smonrou/microprocesador-8bit-ttl/imagenes/cableado_pruebas.jpeg

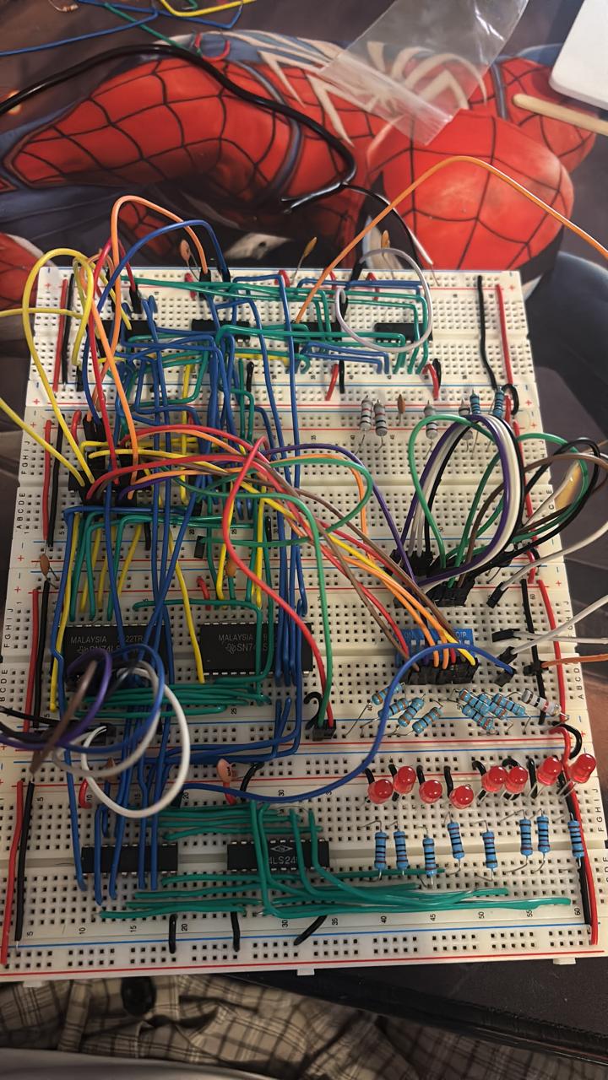
imagenes/cableado_pruebas.jpeg
