smonrou/microprocesador-8bit-ttl/imagenes/pruebas3.jpeg

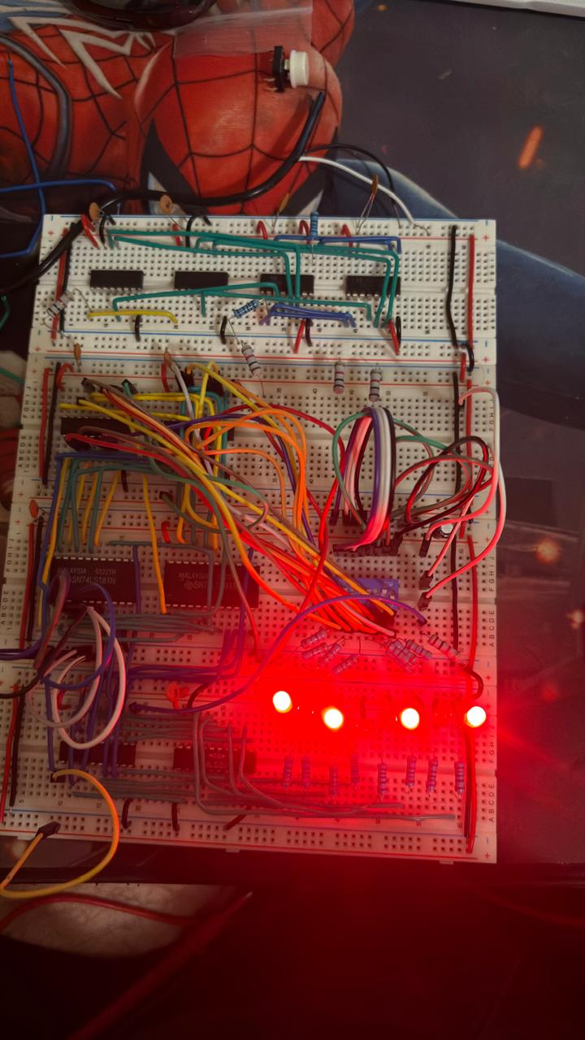
imagenes/pruebas3.jpeg
