smonrou/microprocesador-8bit-ttl/README.md

# Microprocesador 8-bit TTL

Microprocesador de 8 bits construido con lógica TTL discreta (ALU SN74LS181, registros 74LS273, multiplexores 74LS157), controlado por un Arduino Mega que actúa **únicamente** como unidad de control, RAM y reloj. El contador de programa (PC) también es hardware (2× 74LS161) y la salida son 8 LEDs a través de un 74LS240. Toda operación aritmética y lógica ocurre en el hardware TTL, nunca en el microcontrolador.

Este repositorio contiene las implementaciones del mismo ISA (juego de instrucciones), mantenidas sincronizadas por una suite de pruebas compartida:

- **`asm/`**: ensamblador de dos pasadas que traduce programas fuente `.asm` al binario de 256 bytes que carga la máquina.
- **`firmware/`**: firmware en C++ para el Arduino Mega, con una capa HAL que separa el núcleo de control (probado en PC) de las implementaciones reales/simuladas de hardware.
- **`depurador/`**: depurador gráfico (Tkinter) para inspeccionar y depurar la ejecución en el hardware real por puerto serie. No depende de `asm/`.
- **`montaje/`**: fuente de verdad del montaje físico en 4 protoboards (`netlist.py`), generador de planos SVG y guías por fase, y la bitácora de lo que realmente pasó (`bitacora_montaje.md`).
- **`compañero/`**: sketch de un compañero, **externo** al diseño de este repositorio y no cubierto por las pruebas.
- **`programas/`**: programas de ejemplo en ensamblador, incluido el programa de referencia (multiplicación por sumas repetidas) y `diagnostico/` (programas para diagnosticar el cableado).
- **`tests/`**: suite de pruebas que valida que las implementaciones (ensamblador, firmware compilado en PC) produzcan resultados idénticos. No ejercen el hardware físico: eso se prueba en la protoboard (ver `montaje/bitacora_montaje.md`).

## Arquitectura

- **ISA fijo de 16 instrucciones**, opcode de 4 bits en el nibble alto del primer byte, instrucciones de 1 o 2 bytes.
- **Memoria von Neumann de 256 bytes**: `0x00`–`0xBF` programa, `0xC0`–`0xFF` datos (convención respetada por el ensamblador, no impuesta por el hardware).
- **ALU SN74LS181**: suma, resta, AND, OR, XOR; solo estas cinco operaciones actualizan las banderas Z (cero) y C (acarreo).
- **Sintaxis de mnemónicos estilo x86** (desde 2026-09-28): `MOV A,[200]` (directo), `MOV A,5` (inmediato), `MOV [200],A` (guardar); sin `#`.
- **Frontera HAL en el firmware**: el núcleo de control (`nucleo.cpp`) no toca pines ni hace I/O directamente. Corre igual sobre hardware real (`hal_arduino.cpp`) o sobre un emulador de los chips TTL (`hal_falso.cpp`) usado en las pruebas de PC.

## Requisitos

| Requisito | Comprobación |
|---|---|
| Python 3.8 o superior | `python --version` |
| pytest | `python -m pip install pytest` |
| g++ (opcional, para pruebas de firmware) | `g++ --version` |

## Instalación

```bash
git clone https://github.com/smonrou/microprocesador-8bit-ttl.git
cd microprocesador-8bit-ttl
python -m pip install -r requirements.txt   # opcional: solo necesario para conectar por serie a un Arduino real
```

## Uso rápido

```bash
# Ejecutar toda la suite de pruebas
python -m pytest -q

# Ensamblar un programa
python -m asm programas/referencia.asm

# Ver el listado sin escribir archivos
python -m asm programas/referencia.asm --listing-only

# Recorrido de demostración de todo el sistema (8 pasos)
python demo.py
python demo.py 4          # solo el paso 4
python demo.py --lista    # listar pasos disponibles
```

## Ejecutar pruebas específicas

```bash
python -m pytest tests/test_asm_errors.py -v   # un archivo
python -m pytest -k "reference" -v              # por nombre
python -m pytest -k firmware -v                 # solo pruebas de firmware (compilan C++ con g++)
```

## Estructura del repositorio

```
.
├── asm/          # ensamblador de dos pasadas (Python)
├── firmware/     # firmware del Arduino Mega (C++), su capa HAL y los sketches de prueba (prueba_fase4/5)
├── depurador/    # depurador gráfico Tkinter
├── programas/    # programas de ejemplo en ensamblador (+ diagnostico/)
├── montaje/      # netlist, planos, guías por fase y bitácora del montaje físico
├── compañero/    # sketch externo de un compañero (no es parte del diseño)
├── tests/        # suite de pruebas compartida
├── demo.py       # recorrido de demostración end-to-end
├── pytest.ini
├── requirements.txt
└── LICENSE
```

## Estado del proyecto

El diseño lógico, el ensamblador y el firmware están completos y validados por pruebas automatizadas. El circuito físico está terminado en 4 protoboards con el Arduino Mega y **funciona completo** (2026-10-02): las 6 fases del montaje pasaron sus pruebas,.

## Licencia

MIT, ver [LICENSE](LICENSE).
