smonrou/microprocesador-8bit-ttl/imagenes/fase2.jpeg

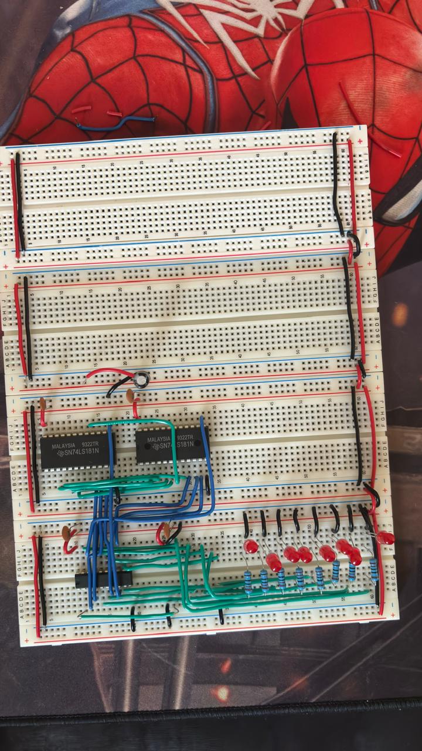
imagenes/fase2.jpeg
