smonrou/microprocesador-8bit-ttl/imagenes/fase4.jpeg

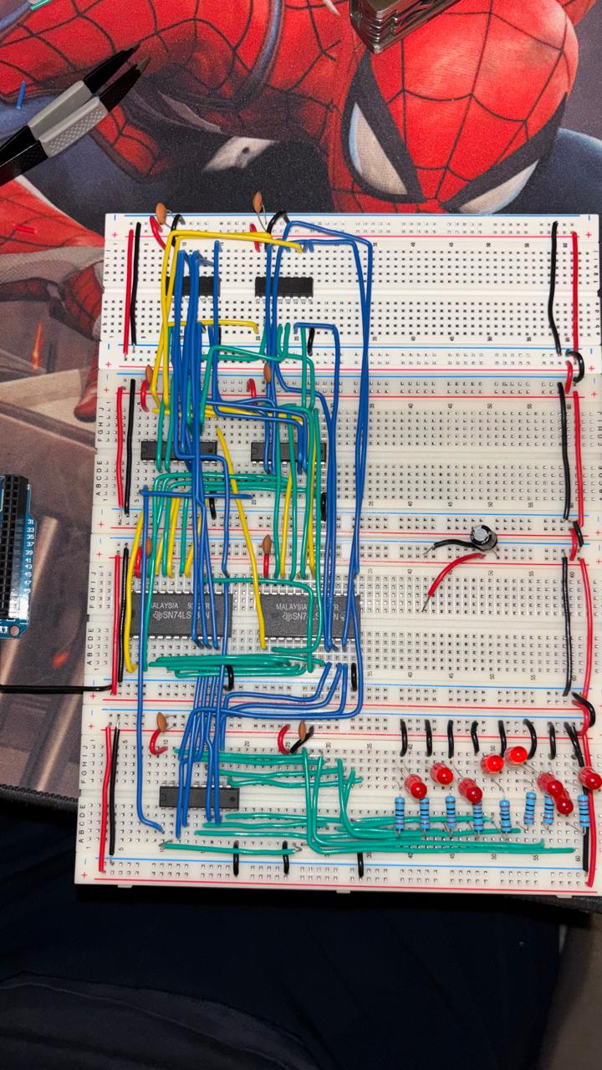
imagenes/fase4.jpeg
