smonrou/microprocesador-8bit-ttl/imagenes/faseFinal.jpeg

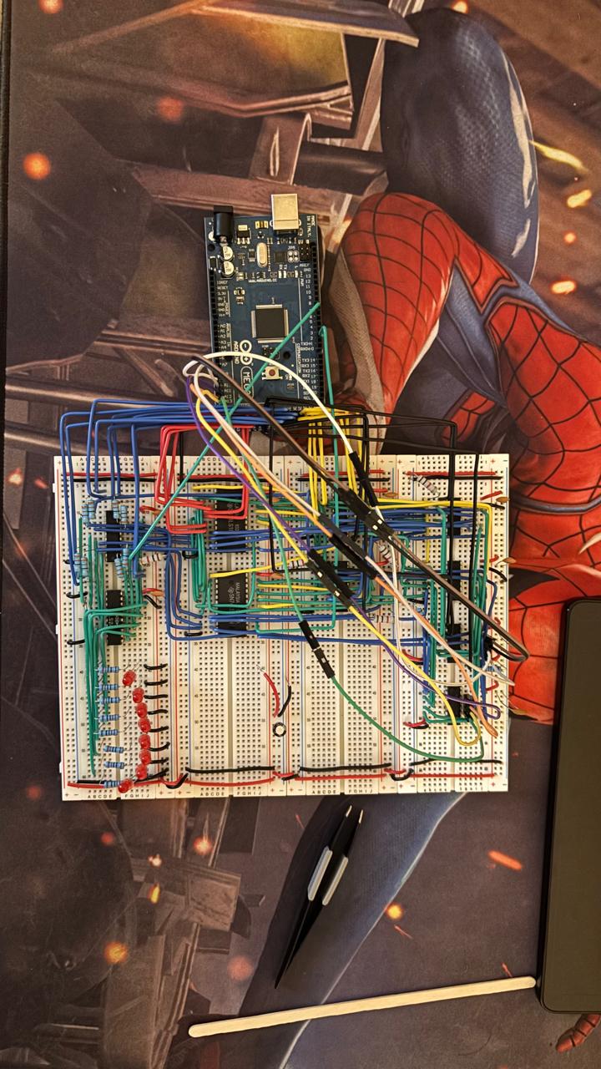
imagenes/faseFinal.jpeg
