smonrou/microprocesador-8bit-ttl/imagenes/WhatsApp Image 2026-10-04 at 1.18.01 PM (1).jpeg

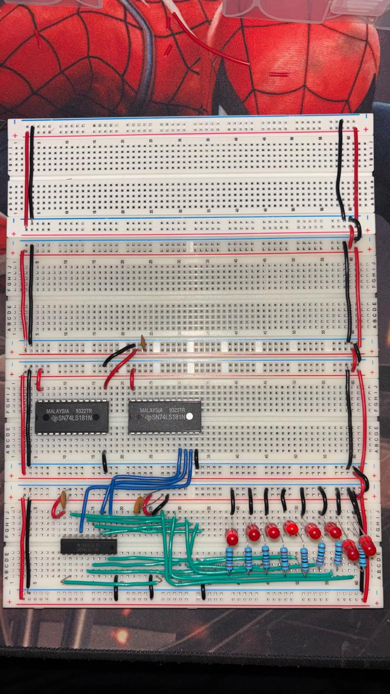
imagenes/WhatsApp Image 2026-10-04 at 1.18.01 PM (1).jpeg
