smonrou/microprocesador-8bit-ttl/depurador/desensamblador.py

"""Desensamblador: bytes de memoria -> mnemónico + operando.

Lee la tabla de opcodes de ``depurador.isa``; este módulo no contiene ni un
solo literal de opcode.

La sintaxis emitida es la misma que acepta el ensamblador (``MOV A,0x04``,
``MOV A,[0xC8]``, ``JNZ 0x0A``), así que lo desensamblado se puede volver a
ensamblar.

Módulo puro: no toca sockets, hilos ni Tkinter.
"""

from dataclasses import dataclass
from typing import List, Optional, Sequence

from .isa import TABLA_DE_OPCODES

TAMANO_MEMORIA = 256


@dataclass(frozen=True)
class LineaDesensamblada:
    direccion: int
    bytes_crudos: List[int]
    mnemonico: str
    operando: Optional[int]
    texto: str          # "MOV A,[0xC8]" — listo para pintar

    @property
    def longitud(self) -> int:
        return len(self.bytes_crudos)


def _leer(memoria: Sequence[int], direccion: int) -> int:
    return memoria[direccion & 0xFF] & 0xFF


def desensamblar_en(memoria: Sequence[int], direccion: int) -> LineaDesensamblada:
    """Desensambla la instrucción que empieza en ``direccion``.

    El opcode son SIEMPRE los 4 bits altos del primer byte (A.4), así que
    cualquier byte decodifica: no existe el "opcode inválido". Los 4 bits bajos
    del primer byte no se usan y se ignoran, igual que en el hardware.
    """
    direccion &= 0xFF
    primero = _leer(memoria, direccion)
    spec = TABLA_DE_OPCODES[primero >> 4]

    if spec.longitud == 1:
        return LineaDesensamblada(
            direccion=direccion,
            bytes_crudos=[primero],
            mnemonico=spec.mnemonico,
            operando=None,
            texto=spec.mnemonico,
        )

    operando = _leer(memoria, direccion + 1)
    valor = f"0x{operando:02X}"
    if "[dir]" in spec.mnemonico:          # MOV A,[dir] / MOV [dir],A
        texto = spec.mnemonico.replace("[dir]", f"[{valor}]")
    elif spec.mnemonico.endswith(",inm"):  # MOV A,inm
        texto = spec.mnemonico[: -len("inm")] + valor
    else:                                 # JMP/JZ/JNZ: dirección pelada
        texto = f"{spec.mnemonico} {valor}"

    return LineaDesensamblada(
        direccion=direccion,
        bytes_crudos=[primero, operando],
        mnemonico=spec.mnemonico,
        operando=operando,
        texto=texto,
    )


def mnemonico_de(ir: int) -> str:
    """El nemónico de un IR suelto, sin necesidad de la memoria.

    Sirve para la línea ``#pc=...`` de STATE, que trae el IR pero no el
    operando. El opcode son los 4 bits altos (A.4), así que los 16 valores
    existen y esto nunca falla.
    """
    return TABLA_DE_OPCODES[(ir >> 4) & 0xF].mnemonico


def desensamblar(memoria: Sequence[int], inicio: int = 0,
                 fin: int = TAMANO_MEMORIA - 1) -> List[LineaDesensamblada]:
    """Desensambla linealmente desde ``inicio`` hasta ``fin`` (ambos incluidos).

    Lineal a propósito: no sigue saltos ni intenta adivinar dónde acaba el
    código y empieza la zona de datos. El mapa 0x00-0xBF / 0xC0-0xFF es una
    CONVENCIÓN (A.6), no algo que el hardware imponga, así que un desensamblador
    que decidiera solo dónde cortar estaría inventando.

    Una instrucción de 2 bytes que empieza justo en ``fin`` se emite completa.
    """
    lineas: List[LineaDesensamblada] = []
    direccion = inicio
    while direccion <= fin:
        linea = desensamblar_en(memoria, direccion)
        lineas.append(linea)
        direccion += linea.longitud
    return lineas


def indice_por_direccion(lineas: Sequence[LineaDesensamblada]) -> dict:
    """Mapa dirección -> posición en la lista, para resaltar la línea del PC.

    Solo se indexa el PRIMER byte de cada instrucción: si el PC cayera en el
    operando de una instrucción de 2 bytes (posible con un salto a media
    instrucción), no hay línea que resaltar y es correcto no resaltar ninguna.
    """
    return {linea.direccion: posicion for posicion, linea in enumerate(lineas)}
