smonrou/microprocesador-8bit-ttl/depurador/gui.py

"""Panel frontal en Tkinter del depurador.

Aquí solo se arman widgets y se cablean botones; la lógica que se puede
probar sin pantalla está en los otros módulos del paquete.
"""

import os
import tkinter as tk
from tkinter import filedialog, messagebox, ttk
from typing import List, Optional

from . import (cargador, desensamblador, formato_numerico, protocolo,
               pruebas_rapidas, transporte)

MONOESPACIADA = ("Consolas", 9)
MONOESPACIADA_GRANDE = ("Consolas", 11, "bold")
MONOESPACIADA_COMPACTA = ("Consolas", 7)
TITULO_MEMORIA = "Memoria 256 B"
ANCHO_DESENSAMBLADO = 28
ANCHO_DESENSAMBLADO_COMPACTO = 24

COLOR_FONDO = "#1e1e1e"
COLOR_PANEL = "#252526"
COLOR_TEXTO = "#d4d4d4"
COLOR_APAGADO = "#6a6a6a"
COLOR_RESALTE = "#264f78"
COLOR_ACTIVO = "#4ec9b0"
COLOR_BANDERA = "#f0c674"
COLOR_ENVIADO = "#569cd6"

MILISEGUNDOS_ENTRE_DRENAJES = 50
RETARDO_POR_DEFECTO = 200
FILAS_MEMORIA = 16
COLUMNAS_MEMORIA = 16


class Depurador:
    def __init__(self, raiz: tk.Tk) -> None:
        self.raiz = raiz
        self.raiz.title("Depurador: microprocesador de 8 bits")
        self.raiz.configure(bg=COLOR_FONDO)

        self.canal: Optional[transporte.Transporte] = None
        self.ensamblador = protocolo.EnsambladorDeBloques()
        self.memoria: List[int] = [0] * 256
        self.pendientes_de_carga: List[str] = []
        self.corriendo = False
        self.registro_a = 0
        self.registro_b = 0
        self.pc = 0
        self.ir = 0
        self.lineas_desensambladas: List[desensamblador.LineaDesensamblada] = []
        self.pasos_prueba: List[pruebas_rapidas.Paso] = []

        self._construir()
        self._pintar_memoria()
        self._pintar_desensamblado()
        self._refrescar_puertos()
        self.raiz.after(MILISEGUNDOS_ENTRE_DRENAJES, self._drenar)
        self.raiz.protocol("WM_DELETE_WINDOW", self._al_cerrar)

    def _construir(self) -> None:
        self._construir_barra_conexion()

        cuerpo = tk.Frame(self.raiz, bg=COLOR_FONDO)
        cuerpo.pack(fill="both", expand=True, padx=6, pady=4)

        izquierda = tk.Frame(cuerpo, bg=COLOR_FONDO)
        izquierda.pack(side="left", fill="y")
        self._construir_registros(izquierda)
        self._construir_banderas(izquierda)
        self._construir_alu(izquierda)
        self._construir_controles(izquierda)

        centro = tk.Frame(cuerpo, bg=COLOR_FONDO)
        centro.pack(side="left", fill="both", expand=True, padx=6)
        self._construir_memoria(centro)

        derecha = tk.Frame(cuerpo, bg=COLOR_FONDO)
        derecha.pack(side="left", fill="both")
        self._construir_desensamblado(derecha)

        # oculto hasta pulsar Pruebas rápidas
        self.marco_pruebas = tk.Frame(cuerpo, bg=COLOR_FONDO)
        self._construir_pruebas_rapidas(self.marco_pruebas)

        self._construir_registros_de_texto()

    def _marco(self, padre, titulo) -> tk.LabelFrame:
        return tk.LabelFrame(padre, text=titulo, bg=COLOR_PANEL, fg=COLOR_ACTIVO,
                             font=MONOESPACIADA, bd=1, relief="solid",
                             labelanchor="nw", padx=6, pady=4)

    def _etiqueta(self, padre, texto="", color=COLOR_TEXTO,
                  fuente=MONOESPACIADA, **opciones) -> tk.Label:
        return tk.Label(padre, text=texto, bg=COLOR_PANEL, fg=color,
                        font=fuente, anchor="w", **opciones)

    def _construir_barra_conexion(self) -> None:
        barra = tk.Frame(self.raiz, bg=COLOR_PANEL, pady=4, padx=6)
        barra.pack(fill="x")

        tk.Label(barra, text="puerto serie:", bg=COLOR_PANEL, fg=COLOR_TEXTO,
                 font=MONOESPACIADA).pack(side="left")
        self.puerto_elegido = tk.StringVar()
        self.combo_puertos = ttk.Combobox(barra, textvariable=self.puerto_elegido,
                                          width=14, state="readonly",
                                          font=MONOESPACIADA)
        self.combo_puertos.pack(side="left", padx=4)

        self.boton_refrescar = tk.Button(barra, text="↻", font=MONOESPACIADA,
                                         command=self._refrescar_puertos)
        self.boton_refrescar.pack(side="left")

        self.boton_conectar = tk.Button(barra, text="Conectar", font=MONOESPACIADA,
                                        width=12, command=self._alternar_conexion)
        self.boton_conectar.pack(side="left", padx=8)

        self.estado_conexion = tk.Label(barra, text="desconectado", bg=COLOR_PANEL,
                                        fg=COLOR_APAGADO, font=MONOESPACIADA)
        self.estado_conexion.pack(side="left")

        self.boton_pruebas = tk.Button(barra, text="Pruebas rápidas ▸",
                                       font=MONOESPACIADA,
                                       command=self._alternar_pruebas)
        self.boton_pruebas.pack(side="right")

    def _construir_registros(self, padre) -> None:
        marco = self._marco(padre, "Registros (74LS273)")
        marco.pack(fill="x", pady=2)

        encabezados = ("", "hex", "binario", "sin signo", "con signo")
        for columna, texto in enumerate(encabezados):
            self._etiqueta(marco, texto, COLOR_APAGADO).grid(
                row=0, column=columna, sticky="w", padx=4)

        self.celdas_registro = {}
        for fila, nombre in enumerate(("A", "B"), start=1):
            self._etiqueta(marco, nombre, COLOR_ACTIVO,
                           MONOESPACIADA_GRANDE).grid(row=fila, column=0, padx=4)
            self.celdas_registro[nombre] = []
            for columna in range(1, 5):
                celda = self._etiqueta(marco, "-", width=11)
                celda.grid(row=fila, column=columna, sticky="w", padx=4)
                self.celdas_registro[nombre].append(celda)

        marco_control = self._marco(padre, "Unidad de control")
        marco_control.pack(fill="x", pady=2)
        self.etiqueta_pc = self._etiqueta(marco_control, "PC  = 0x00  (0)")
        self.etiqueta_pc.pack(fill="x")
        self.etiqueta_ir = self._etiqueta(marco_control, "IR  = 0x00  NOP")
        self.etiqueta_ir.pack(fill="x")
        self.etiqueta_ciclo = self._etiqueta(marco_control, "ciclo -   paso -",
                                             COLOR_APAGADO)
        self.etiqueta_ciclo.pack(fill="x")

    def _construir_banderas(self, padre) -> None:
        marco = self._marco(padre, "Banderas")
        marco.pack(fill="x", pady=2)

        self.etiquetas_bandera = {}
        for columna, (nombre, ayuda) in enumerate(
                (("Z", "resultado cero"), ("C", "acarreo"))):
            caja = tk.Frame(marco, bg=COLOR_PANEL)
            caja.grid(row=0, column=columna, padx=10, pady=2)
            etiqueta = tk.Label(caja, text=f"{nombre}=0", bg=COLOR_FONDO,
                                fg=COLOR_APAGADO, font=MONOESPACIADA_GRANDE,
                                width=5, relief="solid", bd=1)
            etiqueta.pack()
            tk.Label(caja, text=ayuda, bg=COLOR_PANEL, fg=COLOR_APAGADO,
                     font=("Consolas", 7)).pack()
            self.etiquetas_bandera[nombre] = etiqueta

        self.etiqueta_detenido = self._etiqueta(marco, "CPU lista", COLOR_ACTIVO)
        self.etiqueta_detenido.grid(row=1, column=0, columnspan=2, sticky="w")

    def _construir_alu(self, padre) -> None:
        marco = self._marco(padre, "ALU 2x SN74LS181")
        marco.pack(fill="x", pady=2)
        self.etiqueta_alu = self._etiqueta(marco, "M=-  S=----  Cn=-")
        self.etiqueta_alu.pack(fill="x")
        self.etiqueta_alu_nota = self._etiqueta(
            marco, "(sin operación de ALU todavía)", COLOR_APAGADO)
        self.etiqueta_alu_nota.pack(fill="x")

    def _construir_controles(self, padre) -> None:
        marco = self._marco(padre, "Ejecución")
        marco.pack(fill="x", pady=2)

        botones = tk.Frame(marco, bg=COLOR_PANEL)
        botones.pack(fill="x")
        self.botones_comando = {}
        for columna, orden in enumerate(("RUN", "STEP", "RESET", "BORRAR")):
            boton = tk.Button(botones, text=orden, font=MONOESPACIADA, width=7,
                              state="disabled",
                              command=lambda o=orden: self._enviar_comando(o))
            boton.grid(row=0, column=columna, padx=2, pady=2)
            self.botones_comando[orden] = boton

        self.boton_estado = tk.Button(botones, text="STATE", font=MONOESPACIADA,
                                      width=7, state="disabled",
                                      command=lambda: self._enviar_comando("STATE"))
        self.boton_estado.grid(row=1, column=0, padx=2, pady=2)
        self.botones_comando["STATE"] = self.boton_estado

        self.boton_dump = tk.Button(botones, text="DUMP", font=MONOESPACIADA,
                                    width=7, state="disabled",
                                    command=self._pedir_memoria)
        self.boton_dump.grid(row=1, column=1, padx=2, pady=2)
        self.botones_comando["DUMP"] = self.boton_dump

        self.boton_cargar = tk.Button(botones, text="Cargar .load",
                                      font=MONOESPACIADA, width=16,
                                      state="disabled", command=self._cargar_archivo)
        self.boton_cargar.grid(row=1, column=2, columnspan=2, padx=2, pady=2)
        self.botones_comando["CARGAR"] = self.boton_cargar

        # VEL: retardo entre instrucciones en RUN, 0-5000 ms
        velocidad = tk.Frame(marco, bg=COLOR_PANEL)
        velocidad.pack(fill="x", pady=(6, 0))
        tk.Label(velocidad, text="VEL", bg=COLOR_PANEL, fg=COLOR_TEXTO,
                 font=MONOESPACIADA).pack(side="left")
        self.velocidad = tk.IntVar(value=RETARDO_POR_DEFECTO)
        tk.Scale(velocidad, from_=0, to=5000, resolution=50, orient="horizontal",
                 variable=self.velocidad, bg=COLOR_PANEL, fg=COLOR_TEXTO,
                 troughcolor=COLOR_FONDO, highlightthickness=0, length=170,
                 font=("Consolas", 7)).pack(side="left", fill="x", expand=True)
        self.boton_velocidad = tk.Button(velocidad, text="ms", font=MONOESPACIADA,
                                         state="disabled",
                                         command=self._aplicar_velocidad)
        self.boton_velocidad.pack(side="left")
        self.botones_comando["VEL"] = self.boton_velocidad

    def _construir_memoria(self, padre) -> None:
        marco = self._marco(padre, TITULO_MEMORIA)
        marco.pack(fill="both", expand=True)
        self.marco_memoria = marco

        rejilla = tk.Frame(marco, bg=COLOR_PANEL)
        rejilla.pack()

        self.ejes_memoria = []
        for columna in range(COLUMNAS_MEMORIA):
            eje = self._etiqueta(rejilla, f"{columna:X}", COLOR_APAGADO)
            eje.grid(row=0, column=columna + 1, padx=1)
            self.ejes_memoria.append(eje)

        self.celdas_memoria = []
        for fila in range(FILAS_MEMORIA):
            eje = self._etiqueta(rejilla, f"{fila * 16:02X}", COLOR_APAGADO)
            eje.grid(row=fila + 1, column=0, padx=(0, 4))
            self.ejes_memoria.append(eje)
            for columna in range(COLUMNAS_MEMORIA):
                celda = tk.Label(rejilla, text="00", bg=COLOR_FONDO, fg=COLOR_TEXTO,
                                 font=MONOESPACIADA, width=2, padx=2)
                celda.grid(row=fila + 1, column=columna + 1, padx=1, pady=1)
                self.celdas_memoria.append(celda)

    def _construir_desensamblado(self, padre) -> None:
        marco = self._marco(padre, "Desensamblado")
        marco.pack(fill="both", expand=True)

        self.lista_desensamblado = tk.Listbox(
            marco, font=MONOESPACIADA, bg=COLOR_FONDO, fg=COLOR_TEXTO,
            width=ANCHO_DESENSAMBLADO, height=24, selectbackground=COLOR_RESALTE, selectforeground="white",
            highlightthickness=0, bd=0, activestyle="none")
        self.lista_desensamblado.pack(side="left", fill="both", expand=True)
        barra = tk.Scrollbar(marco, command=self.lista_desensamblado.yview)
        barra.pack(side="right", fill="y")
        self.lista_desensamblado.config(yscrollcommand=barra.set)

    def _construir_pruebas_rapidas(self, padre) -> None:
        marco = self._marco(padre, "Pruebas rápidas")
        marco.pack(fill="both", expand=True)

        fila_valor = tk.Frame(marco, bg=COLOR_PANEL)
        fila_valor.pack(fill="x")
        self._etiqueta(fila_valor, "valor v:").pack(side="left")
        self.valor_prueba = tk.StringVar(value="0")
        tk.Entry(fila_valor, textvariable=self.valor_prueba, width=10,
                 font=MONOESPACIADA, bg=COLOR_FONDO, fg=COLOR_TEXTO,
                 insertbackground=COLOR_TEXTO).pack(side="left", padx=4)

        botonera = tk.Frame(marco, bg=COLOR_PANEL)
        botonera.pack(fill="x", pady=(4, 0))
        filas = (
            ((pruebas_rapidas.CARGAR_A, "A ← v"), (pruebas_rapidas.CARGAR_B, "B ← v")),
            ((pruebas_rapidas.NOT_A, "NOT A"), (pruebas_rapidas.NOT_B, "NOT B"),
             (pruebas_rapidas.NEG_A, "NEG A"), (pruebas_rapidas.NEG_B, "NEG B")),
            tuple((op, op) for op in pruebas_rapidas.OPERACIONES_ALU),
            ((pruebas_rapidas.SALIDA, "OUT"),),
        )
        for numero_fila, fila in enumerate(filas):
            for columna, (tipo, texto) in enumerate(fila):
                tk.Button(botonera, text=texto, font=MONOESPACIADA, width=6,
                          command=lambda t=tipo: self._agregar_paso(t)).grid(
                    row=numero_fila, column=columna, padx=1, pady=1, sticky="w")

        self.out_tras_cada = tk.BooleanVar(value=False)
        tk.Checkbutton(
            marco, text="OUT tras cada paso",
            variable=self.out_tras_cada, bg=COLOR_PANEL, fg=COLOR_TEXTO,
            selectcolor=COLOR_FONDO, activebackground=COLOR_PANEL,
            activeforeground=COLOR_TEXTO, font=MONOESPACIADA,
            command=self._alternar_out_tras_cada,
        ).pack(anchor="w", pady=(4, 0))

        self._etiqueta(marco, "pasos",
                       COLOR_APAGADO).pack(fill="x", pady=(4, 0))
        self.lista_pasos = tk.Listbox(
            marco, font=MONOESPACIADA, bg=COLOR_FONDO, fg=COLOR_TEXTO, width=38,
            height=5, highlightthickness=0, bd=0, activestyle="none",
            selectbackground=COLOR_RESALTE)
        self.lista_pasos.pack(fill="x")

        self.etiqueta_prueba = self._etiqueta(marco, "", COLOR_APAGADO)
        self.etiqueta_prueba.pack(fill="x", pady=(2, 0))

        self._etiqueta(marco, "ensamblador generado", COLOR_APAGADO).pack(fill="x")
        caja_asm = tk.Frame(marco, bg=COLOR_PANEL)
        caja_asm.pack(fill="both", expand=True)
        self.texto_asm = self._texto(caja_asm, alto=8, ancho=36)

        acciones = tk.Frame(marco, bg=COLOR_PANEL)
        acciones.pack(fill="x", pady=(4, 0))
        for texto, accion in (("Deshacer", self._deshacer_paso),
                              ("Limpiar", self._limpiar_pasos),
                              ("Guardar", self._guardar_prueba)):
            tk.Button(acciones, text=texto, font=MONOESPACIADA,
                      command=accion).pack(side="left", padx=1)
        self.boton_ejecutar_prueba = tk.Button(
            acciones, text="Cargar y ejecutar", font=MONOESPACIADA,
            state="disabled", command=self._ejecutar_prueba)
        self.boton_ejecutar_prueba.pack(side="right", padx=1)
        self.botones_comando["PRUEBA"] = self.boton_ejecutar_prueba

        self._refrescar_prueba()

    def _construir_registros_de_texto(self) -> None:
        abajo = tk.Frame(self.raiz, bg=COLOR_FONDO)
        abajo.pack(fill="both", expand=True, padx=6, pady=(0, 6))

        marco_salida = self._marco(abajo, "Salidas (OUT)")
        marco_salida.pack(side="left", fill="both", expand=True, padx=(0, 3))
        tk.Button(marco_salida, text="Limpiar", font=MONOESPACIADA,
                  command=lambda: self._limpiar(self.log_salidas)).pack(
            side="bottom", anchor="e", pady=(4, 0))
        self.log_salidas = self._texto(marco_salida, alto=8)

        marco_trafico = self._marco(abajo, "Tráfico crudo")
        marco_trafico.pack(side="left", fill="both", expand=True, padx=(3, 0))
        tk.Button(marco_trafico, text="Limpiar", font=MONOESPACIADA,
                  command=lambda: self._limpiar(self.log_trafico)).pack(
            side="bottom", anchor="e", pady=(4, 0))
        self.log_trafico = self._texto(marco_trafico, alto=8)
        self.log_trafico.tag_configure("enviado", foreground=COLOR_ENVIADO)
        self.log_trafico.tag_configure("aviso", foreground=COLOR_BANDERA)

    def _texto(self, padre, alto, ancho=80) -> tk.Text:
        caja = tk.Text(padre, height=alto, width=ancho, font=MONOESPACIADA,
                       bg=COLOR_FONDO,
                       fg=COLOR_TEXTO, insertbackground=COLOR_TEXTO,
                       highlightthickness=0, bd=0, wrap="none", state="disabled")
        caja.pack(side="left", fill="both", expand=True)
        barra = tk.Scrollbar(padre, command=caja.yview)
        barra.pack(side="right", fill="y")
        caja.config(yscrollcommand=barra.set)
        return caja

    def _escribir(self, caja: tk.Text, texto: str, etiqueta: str = "") -> None:
        caja.config(state="normal")
        caja.insert("end", texto + "\n", etiqueta or ())
        caja.see("end")
        caja.config(state="disabled")

    def _limpiar(self, caja: tk.Text) -> None:
        caja.config(state="normal")
        caja.delete("1.0", "end")
        caja.config(state="disabled")

    def _refrescar_puertos(self) -> None:
        puertos = transporte.listar_puertos_serie()
        self.combo_puertos["values"] = puertos
        if puertos and not self.puerto_elegido.get():
            self.puerto_elegido.set(puertos[0])
        if not puertos and not transporte.hay_pyserial():
            self.combo_puertos.set("(falta pyserial)")

    def _alternar_conexion(self) -> None:
        if self.canal is not None:
            self._desconectar()
        else:
            self._conectar()

    def _conectar(self) -> None:
        try:
            puerto = self.puerto_elegido.get()
            if not puerto or puerto.startswith("("):
                messagebox.showwarning("Depurador", "Elige un puerto serie.")
                return
            self.canal = transporte.TransporteSerial(puerto)
            self.canal.abrir()
        except Exception as error:
            self._desconectar()
            messagebox.showerror("Depurador", f"No se pudo conectar:\n{error}")
            return

        self.ensamblador = protocolo.EnsambladorDeBloques()
        self.estado_conexion.config(text=self.canal.descripcion(), fg=COLOR_ACTIVO)
        self.boton_conectar.config(text="Desconectar")
        for boton in self.botones_comando.values():
            boton.config(state="normal")
        self._escribir(self.log_trafico, f"conectado: {self.canal.descripcion()}",
                       "aviso")
        self._aplicar_velocidad()
        self._pedir_memoria()

    def _desconectar(self) -> None:
        if self.canal is not None:
            self.canal.cerrar()
            self.canal = None
        self.pendientes_de_carga = []
        self.estado_conexion.config(text="desconectado", fg=COLOR_APAGADO)
        self.boton_conectar.config(text="Conectar")
        for boton in self.botones_comando.values():
            boton.config(state="disabled")

    def _al_cerrar(self) -> None:
        self._desconectar()
        self.raiz.destroy()

    def _enviar(self, orden: str) -> None:
        if self.canal is None:
            return
        try:
            self.canal.enviar_linea(orden)
        except Exception as error:
            self._escribir(self.log_trafico, f"error al enviar: {error}", "aviso")
            self._desconectar()
            return
        self._escribir(self.log_trafico, f"> {orden}", "enviado")

    def _enviar_comando(self, orden: str) -> None:
        self._enviar(orden)
        if orden in ("RESET", "BORRAR"):
            self.pendientes_de_carga = []
            self.corriendo = False
            self._pedir_memoria()

    def _aplicar_velocidad(self) -> None:
        self._enviar(f"VEL {self.velocidad.get()}")

    def _pedir_memoria(self) -> None:
        self._enviar("DUMP")

    def _cargar_archivo(self) -> None:
        ruta = filedialog.askopenfilename(
            title="Abrir un .load generado por «python -m asm»",
            initialdir=os.path.join(os.getcwd(), "programas"),
            filetypes=[("Guiones de carga", "*.load"), ("Todos", "*.*")])
        if not ruta:
            return
        try:
            lineas = cargador.leer_lineas(ruta)
        except OSError as error:
            messagebox.showerror("Depurador", f"No se pudo leer:\n{error}")
            return
        self._cargar_lineas(lineas, os.path.basename(ruta))

    def _cargar_lineas(self, lineas: List[str], nombre: str,
                       ejecutar: bool = False) -> None:
        if ejecutar:
            lineas = ["BORRAR", *lineas, "DUMP", "RESET", "RUN"]
        self.pendientes_de_carga = list(lineas)
        self._escribir(self.log_trafico,
                       f"cargando {nombre} "
                       f"({len(lineas)} líneas, una a una)", "aviso")
        self._enviar_siguiente_de_la_carga()

    def _enviar_siguiente_de_la_carga(self) -> None:
        if not self.pendientes_de_carga:
            return
        orden = self.pendientes_de_carga.pop(0)
        self._enviar(orden)
        if orden == "DUMP" and self.pendientes_de_carga:
            self._enviar_siguiente_de_la_carga()
            return
        if not self.pendientes_de_carga and orden != "RUN":
            self._pedir_memoria()

    def _alternar_pruebas(self) -> None:
        if self.marco_pruebas.winfo_ismapped():
            self.marco_pruebas.pack_forget()
            self._compactar(False)
            self.boton_pruebas.config(text="Pruebas rápidas ▸")
        else:
            self._compactar(True)
            self.marco_pruebas.pack(side="left", fill="both", padx=(6, 0))
            self.boton_pruebas.config(text="Pruebas rápidas ▾")

    def _compactar(self, compacto: bool) -> None:
        """Encoge o restaura memoria y desensamblado."""
        fuente = MONOESPACIADA_COMPACTA if compacto else MONOESPACIADA
        separacion = 0 if compacto else 1
        for eje in self.ejes_memoria:
            eje.config(font=fuente)
        for celda in self.celdas_memoria:
            celda.config(font=fuente, padx=1 if compacto else 2)
            celda.grid_configure(padx=separacion, pady=separacion)
        self.lista_desensamblado.config(
            font=("Consolas", 8) if compacto else MONOESPACIADA,
            width=ANCHO_DESENSAMBLADO_COMPACTO if compacto
            else ANCHO_DESENSAMBLADO)

    def _agregar_paso(self, tipo: str) -> None:
        valor = None
        if tipo in pruebas_rapidas.TIPOS_CON_VALOR:
            try:
                valor = pruebas_rapidas.valor_de_texto(self.valor_prueba.get())
            except ValueError as error:
                self._avisar_prueba(f"valor inválido: {error}")
                return
        self.pasos_prueba.append(pruebas_rapidas.Paso(tipo, valor))
        if not self._refrescar_prueba():
            # no cabe en 0x00-0xBF, se descarta el paso
            self.pasos_prueba.pop()
            mensaje = self.etiqueta_prueba.cget("text")
            self._refrescar_prueba()
            self._avisar_prueba(mensaje)

    def _alternar_out_tras_cada(self) -> None:
        if not self._refrescar_prueba():
            mensaje = self.etiqueta_prueba.cget("text")
            self.out_tras_cada.set(not self.out_tras_cada.get())
            self._refrescar_prueba()
            self._avisar_prueba(mensaje)

    def _deshacer_paso(self) -> None:
        if self.pasos_prueba:
            self.pasos_prueba.pop()
            self._refrescar_prueba()

    def _limpiar_pasos(self) -> None:
        self.pasos_prueba = []
        self._refrescar_prueba()

    def _avisar_prueba(self, texto: str) -> None:
        self.etiqueta_prueba.config(text=texto, fg=COLOR_BANDERA)

    def _refrescar_prueba(self) -> bool:
        """Regenera asm y lista de pasos. False si no cabe."""
        out_tras_cada = self.out_tras_cada.get()
        texto_asm = pruebas_rapidas.generar_asm(self.pasos_prueba, out_tras_cada)
        try:
            resultado = pruebas_rapidas.ensamblar(self.pasos_prueba, out_tras_cada)
        except pruebas_rapidas.ProgramaDemasiadoGrande as error:
            self._avisar_prueba(f"no cabe en 0x00-0xBF: {error}")
            return False

        self.texto_asm.config(state="normal")
        self.texto_asm.delete("1.0", "end")
        self.texto_asm.insert("1.0", texto_asm)
        self.texto_asm.see("end")
        self.texto_asm.config(state="disabled")

        self.lista_pasos.delete(0, "end")
        for numero, paso in enumerate(self.pasos_prueba, start=1):
            self.lista_pasos.insert(
                "end", f"{numero:>2}. {pruebas_rapidas.descripcion(paso)}")
        self.lista_pasos.see("end")

        usados = pruebas_rapidas.bytes_usados(resultado)
        self.etiqueta_prueba.config(
            text=f"{usados} / {pruebas_rapidas.BYTES_DE_PROGRAMA} bytes de programa",
            fg=COLOR_APAGADO)
        return True

    def _guardar_prueba(self) -> None:
        ruta = filedialog.asksaveasfilename(
            title="Guardar la prueba (.asm y .load con el mismo nombre)",
            initialdir=os.path.join(os.getcwd(), "programas"),
            defaultextension=".asm",
            filetypes=[("Ensamblador", "*.asm"), ("Todos", "*.*")])
        if not ruta:
            return
        try:
            ruta_asm, ruta_load = pruebas_rapidas.guardar(
                self.pasos_prueba, ruta, self.out_tras_cada.get())
        except (OSError, pruebas_rapidas.ProgramaDemasiadoGrande) as error:
            messagebox.showerror("Depurador", f"No se pudo guardar:\n{error}")
            return
        self._avisar_prueba(f"guardado {os.path.basename(ruta_asm)} + "
                            f"{os.path.basename(ruta_load)}")

    def _ejecutar_prueba(self) -> None:
        if not self.pasos_prueba:
            self._avisar_prueba("agrega al menos un paso")
            return
        try:
            resultado = pruebas_rapidas.ensamblar(self.pasos_prueba,
                                                  self.out_tras_cada.get())
        except pruebas_rapidas.ProgramaDemasiadoGrande as error:
            messagebox.showerror("Depurador", str(error))
            return
        self._cargar_lineas(pruebas_rapidas.lineas_de_carga(resultado),
                            "prueba rápida", ejecutar=True)

    def _drenar(self) -> None:
        """Vacía la cola del transporte y pinta (hilo principal)."""
        try:
            if self.canal is not None:
                for linea in self.canal.drenar():
                    if linea is transporte.CENTINELA_DESCONEXION:
                        self._escribir(self.log_trafico, "conexión cerrada",
                                       "aviso")
                        self._desconectar()
                        break
                    for mensaje in self.ensamblador.agregar(linea):
                        self._atender_mensaje(mensaje)
        finally:
            self.raiz.after(MILISEGUNDOS_ENTRE_DRENAJES, self._drenar)

    def _atender_mensaje(self, mensaje: protocolo.Mensaje) -> None:
        self._escribir(self.log_trafico, mensaje.texto)

        if mensaje.es_bloque:
            self._actualizar_alu(mensaje.texto)
            return

        linea = mensaje.texto
        if linea.startswith("#"):
            self._actualizar_desde_claves(
                protocolo.parsear_linea_clave_valor(linea) or {})
            return

        fila = protocolo.parsear_fila_dump(linea)
        if fila is not None:
            direccion, bytes_leidos = fila
            for desplazamiento, byte in enumerate(bytes_leidos):
                self.memoria[(direccion + desplazamiento) & 0xFF] = byte
            self._pintar_memoria()
            self._pintar_desensamblado()
            return

        if linea == "--- RUN ---":
            self.corriendo = True
            return
        if linea == "--- HLT ---":
            self.corriendo = False
            self._pedir_memoria()
            return

        if protocolo.es_respuesta_final(linea):
            if linea.startswith("ERR"):
                self.corriendo = False
            self._enviar_siguiente_de_la_carga()

    def _actualizar_desde_claves(self, datos: dict) -> None:
        if "paso" in datos:
            self.etiqueta_ciclo.config(text=f"ciclo -   paso {datos['paso']}")
            return

        es_estado = "ciclo" not in datos  # línea de STATE/RESET

        if "pc" in datos:
            self.pc = int(datos["pc"])
        if "ir" in datos:
            self.ir = int(datos["ir"])

        a_valida = b_valida = True
        if not es_estado:
            a_valida, b_valida = protocolo.registros_significativos(
                str(datos.get("op", "")))
        if a_valida and "a" in datos:
            self.registro_a = int(datos["a"])
        if b_valida and "b" in datos:
            self.registro_b = int(datos["b"])

        self._pintar_registros()

        mnemonico = str(datos.get("op") or desensamblador.mnemonico_de(self.ir))
        self.etiqueta_pc.config(text=f"PC  = 0x{self.pc:02X}  ({self.pc})")
        self.etiqueta_ir.config(text=f"IR  = 0x{self.ir:02X}  {mnemonico}")
        if "ciclo" in datos:
            self.etiqueta_ciclo.config(
                text=f"ciclo {datos['ciclo']}   instrucción completa")

        for nombre in ("z", "c"):
            if nombre in datos:
                encendida = int(datos[nombre]) == 1
                self.etiquetas_bandera[nombre.upper()].config(
                    text=f"{nombre.upper()}={int(datos[nombre])}",
                    fg=COLOR_BANDERA if encendida else COLOR_APAGADO,
                    bg="#3a3320" if encendida else COLOR_FONDO)

        if "halted" in datos:
            detenida = int(datos["halted"]) == 1
            self.etiqueta_detenido.config(
                text="CPU DETENIDA (usa RESET)" if detenida else "CPU lista",
                fg=COLOR_BANDERA if detenida else COLOR_ACTIVO)

        if "salida" in datos:
            resumen = formato_numerico.resumen_numerico(int(datos["salida"]))
            self._escribir(
                self.log_salidas,
                f"OUT  hex {resumen.hexadecimal}   bin {formato_numerico.binario_agrupado(resumen.byte)}"
                f"   sin signo {resumen.sin_signo:>3}   con signo "
                f"{formato_numerico.con_signo_con_letrero(resumen.byte):>4}")

        self._pintar_memoria()
        self._pintar_desensamblado()

        if "ciclo" in datos and not self.corriendo:
            self._pedir_memoria()

    def _pintar_registros(self) -> None:
        for nombre, valor in (("A", self.registro_a), ("B", self.registro_b)):
            resumen = formato_numerico.resumen_numerico(valor)
            textos = (resumen.hexadecimal,
                      formato_numerico.binario_agrupado(resumen.byte),
                      str(resumen.sin_signo),
                      formato_numerico.con_signo_con_letrero(resumen.byte))
            for celda, texto in zip(self.celdas_registro[nombre], textos):
                celda.config(text=texto)

    def _actualizar_alu(self, bloque: str) -> None:
        control = protocolo.extraer_control_alu(bloque)
        if control is None:
            self.etiqueta_alu_nota.config(
                text="(la última instrucción no usó la ALU)")
            return
        self.etiqueta_alu.config(
            text=f"M={control['M']}  S={control['S']}  Cn={control['Cn']}")
        modo = "aritmético" if control["M"] == 0 else "lógico"
        self.etiqueta_alu_nota.config(text=f"M={control['M']} → modo {modo}")

    def _pintar_memoria(self) -> None:
        for direccion, celda in enumerate(self.celdas_memoria):
            byte = self.memoria[direccion]
            es_pc = direccion == self.pc
            celda.config(
                text=f"{byte:02X}",
                bg=COLOR_RESALTE if es_pc else COLOR_FONDO,
                fg="white" if es_pc else (COLOR_TEXTO if byte else COLOR_APAGADO))

    def _pintar_desensamblado(self) -> None:
        self.lineas_desensambladas = desensamblador.desensamblar(self.memoria,
                                                                 0x00, 0xBF)
        self.lista_desensamblado.delete(0, "end")
        for linea in self.lineas_desensambladas:
            bytes_texto = " ".join(f"{b:02X}" for b in linea.bytes_crudos)
            self.lista_desensamblado.insert(
                "end", f"{linea.direccion:02X}  {bytes_texto:<5}  {linea.texto}")

        indice = desensamblador.indice_por_direccion(self.lineas_desensambladas)
        self.lista_desensamblado.selection_clear(0, "end")
        if self.pc in indice:
            posicion = indice[self.pc]
            self.lista_desensamblado.selection_set(posicion)
            self.lista_desensamblado.see(posicion)


def main() -> None:
    raiz = tk.Tk()
    Depurador(raiz)
    raiz.mainloop()
