smonrou/microprocesador-8bit-ttl/(commit log)

2026-09-05 Reemplaza display hexadecimal por salida binaria decodificada en hardware
    Se descarto la decodificacion por software del display de 7 segmentos:
    si se muestra hexadecimal tiene que haber hardware haciendo la conversion, y el Arduino es la unidad de control, no un decodificador. Se paso a binario (8 digitos, uno por bit), donde no hay nada que convertir: el 74LS151 ya publica el bit y su complemento.
    - pines.h/display.h/display.cpp: se elimina la tabla PATRONES[16] y las 9 lineas de segmento/comun; entran 5 pines (SEL0-2, BLANK, CLK) para el nuevo registro de salida (74LS273), el mux 8:1 (74LS151) y el decodificador de digito (74LS138).
    - hal.h/hal_arduino.cpp: mostrarByte() descarta el valo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
2026-09-18 Agrega el plan de montaje físico en 4 protoboards y salida en LEDs
    - montaje/: netlist del montaje (fuente de verdad de cada agujero, cable,
    color y fase), pinouts de TI, generador de planos SVG y de las guías
    HTML por fase, bitácora del montaje y URLs de los artifacts publicados.
    - tests/test_montaje.py: verifica el montaje contra pines.h y una
    especificación lógica independiente (sin entradas flotantes, desacople
    por chip, colores por función, sin agujeros repetidos por fase).
    - Salida del procesador: 8 LEDs con 74LS273 + 74LS244 (reemplaza los 8
    dígitos de 7 segmentos con 74LS151/74LS138). C.1 y C.4 resueltos.
    - Corrige §6.5 del registro de diseño: en el 74LS181 el pin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
    [test_montaje.py]
2026-09-26 Implementa el contador de programa físico con 2x 74LS161
    El ingeniero rechazó el PC como variable del Arduino (pc_++ es un
    cálculo). El PC pasa a ser dos 74LS161 en cascada en BB1: carga
    paralela desde el bus D para los saltos, /CLR compartido con CLEAR,
    reloj en el pin 42 y /LOAD en el 43 (con 1 kΩ de reposo), y Q0-Q7
    leídas por PORTK (A8-A15).
    - firmware: se elimina pc_; FETCH/FETCH2 llaman hal::incrementarPC(),
    los saltos hal::cargarPC(), y pc() lee hal::leerPC(). El HAL falso
    emula el 161 (incluida la vuelta 0xFF -> 0x00).
    - montaje: netlist, pinout del 74LS161, pruebas del PC en la fase 4,
    conexiones al Mega en la fase 5; guías y SVG regenerados.
    - docs: Parte A de contexto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
2026-10-06 comentarios clave para defensa
2026-10-16 Limpia comentarios de depurador/gui.py
2026-10-16 Ajusta comentario de hal::iniciar en unidad_control.ino
2026-10-16 Depurador sin dependencia de sim/ ni asm/
    Agrega depurador/isa.py con la tabla de opcodes propia. Quita el servidor
    falso, TransporteSocket y la predicción por simulador. Las pruebas rápidas
    codifican a bytes sin asm.assemble (verificado idéntico en 300 casos
    aleatorios contra el ensamblador anterior).
2026-10-16 asm/ sin dependencia de sim/
    Agrega asm/isa.py con la tabla de opcodes y MEMORY_SIZE propios. Quita
    la opción --run (que ejecutaba en el simulador) y actualiza README,
    guion_asm.md y programas/demos/LEEME.md. Salida de asm idéntica a la
    anterior en los 17 programas de programas/ y en los casos de error.
2026-10-16 Elimina sim/ y demo.py de la rama
    Quita el simulador y el script de demostración que dependía de él, y
    las menciones en README, LEEME y comentarios del firmware.
2026-10-16 Limpia comentarios de asm/ y programas/
    En asm/ se quitan los comentarios y docstrings redundantes, dejando
    solo notas cortas del porqué. En programas/ quedan únicamente los
    comentarios sobre los resultados esperados.
    Se elimina además una línea suelta en demostracion_operaciones.asm que
    impedía ensamblarlo.
